w-dee/dotmatrix_64x48_hw_5.0/dotmatrix_64x48.pdf

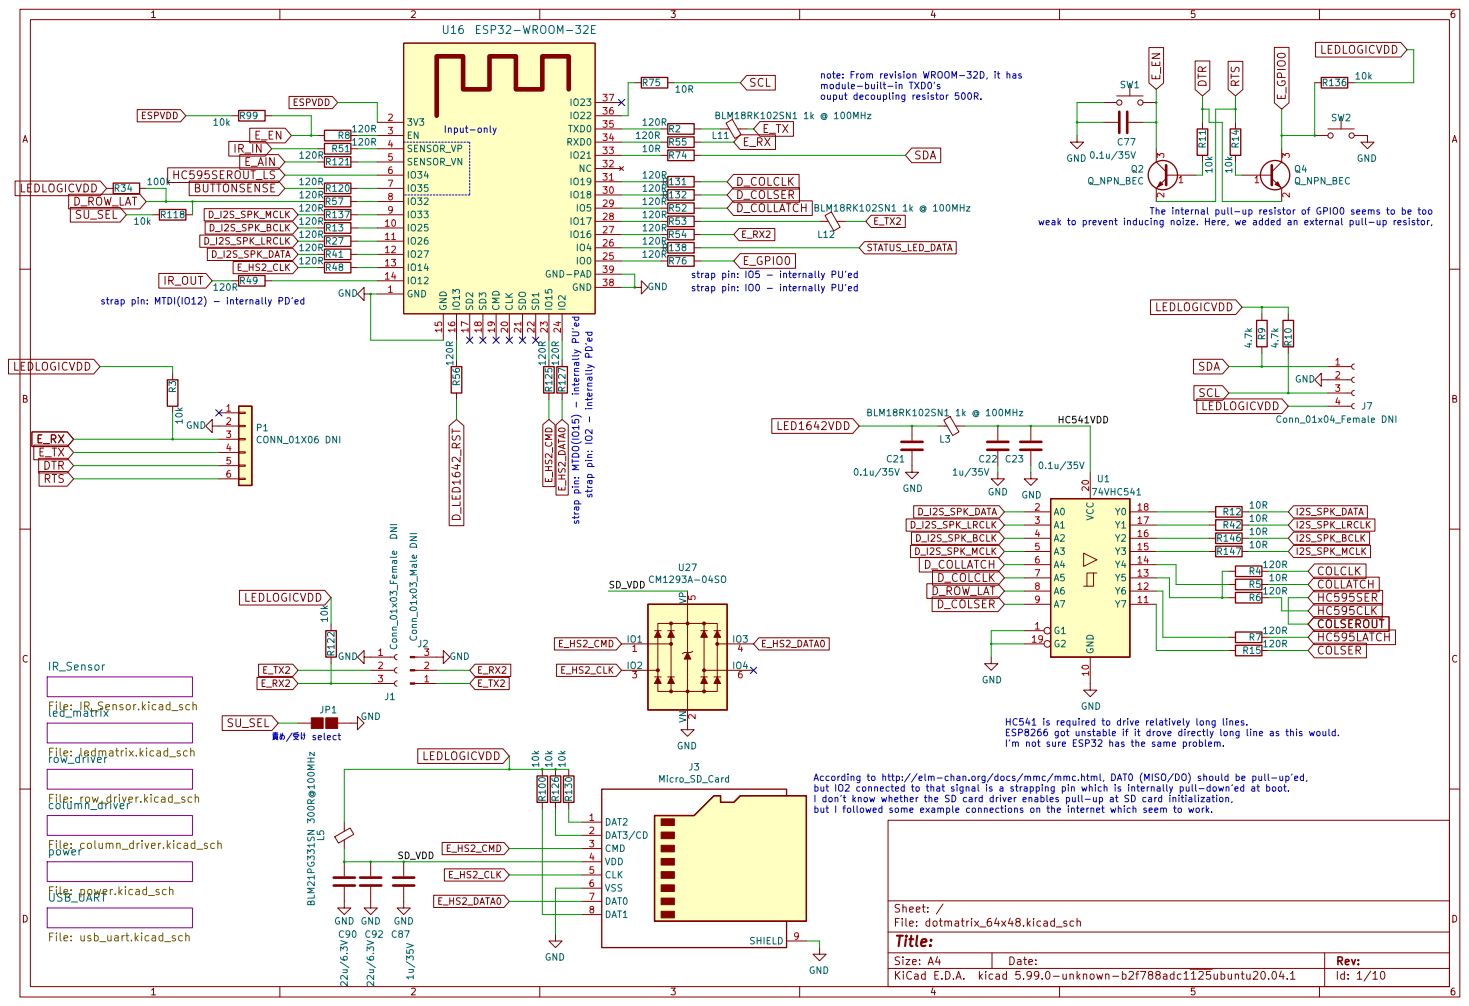
[picture p7: page 1]

note: From revision WROOM-32D, it has module-built-in TXD0's ouput decoupling resistor 500R.

The internal pull-up resistor of GPIO0 seems to be too

weak to prevent inducing noize. Here, we added an external pull-up resistor,

strap pin: IO5 - internally PU'ed
strap pin: IO0 - internally PU'ed

HC541 is required to drive relatively long lines.
ESP8266 got unstable if it drove directly long line as this would.
I'm not sure ESP32 has the same problem.

According to http://elm-chan.org/docs/mmc/mmc.html, DAT0 (MISO/DO) should be pull-up'ed,
but IO2 connected to that signal is a strapping pin which is internally pull-down'ed at boot.
I don't know whether the SD card driver enables pull-up at SD card initialization,
but I followed some example connections on the internet which seem to work.

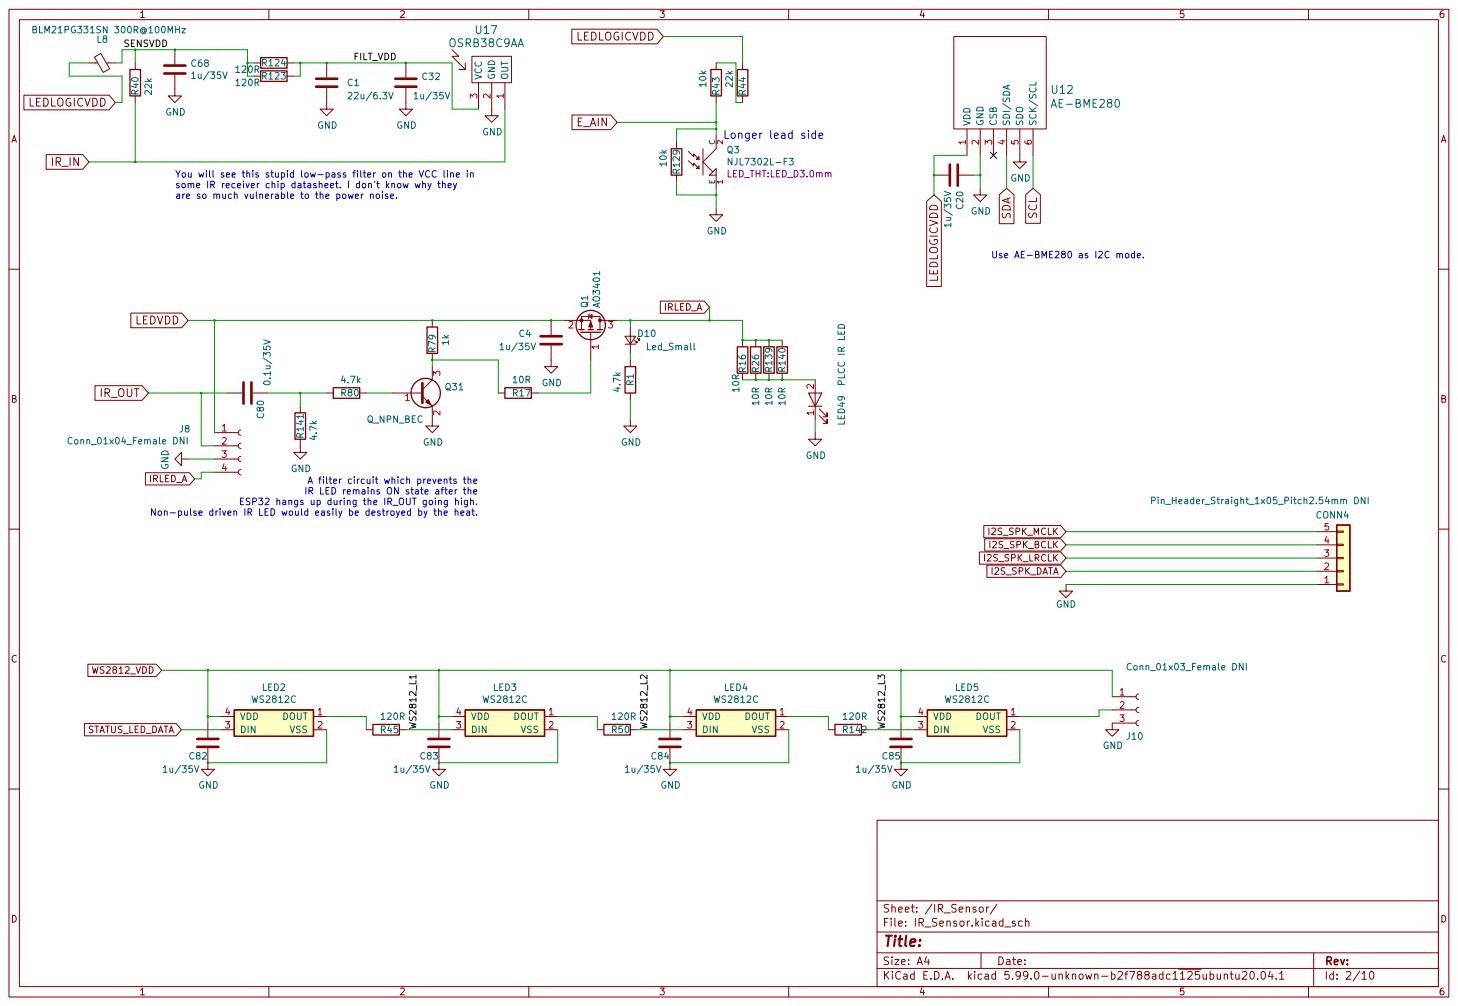
[picture p8: page 2]

You will see this stupid low-pass filter on the VCC line in
some IR receiver chip datasheet. I don't know why they
are so much vulnerable to the power noise.

1 2 LED49 PLCC IR LED GND GND

IR LED remains ON state after the ESP32 hangs up during the IR_OUT going high.

Non-pulse driven IR LED would easily be destroyed by the heat.

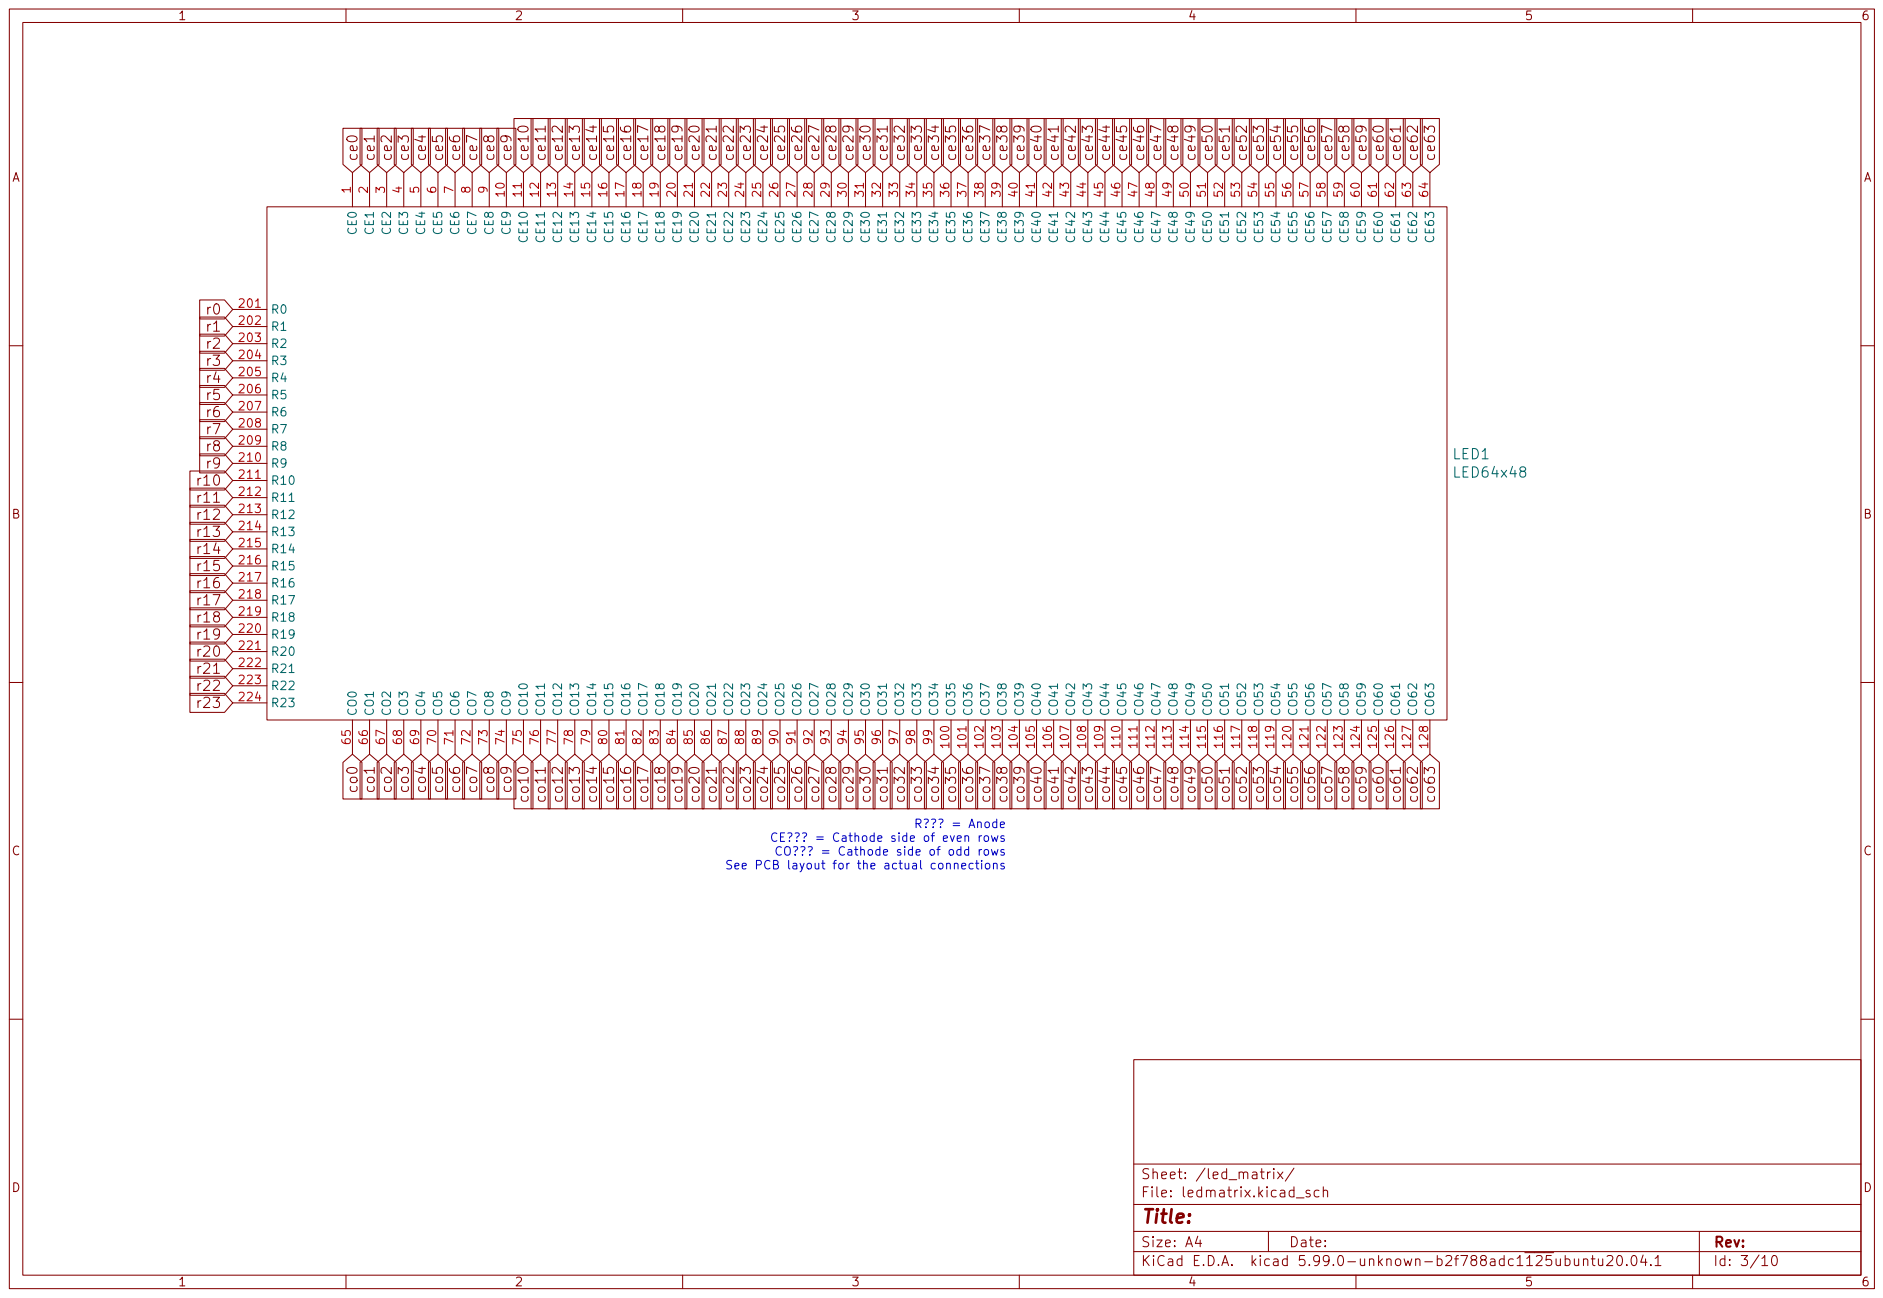
[picture p9: page 3]

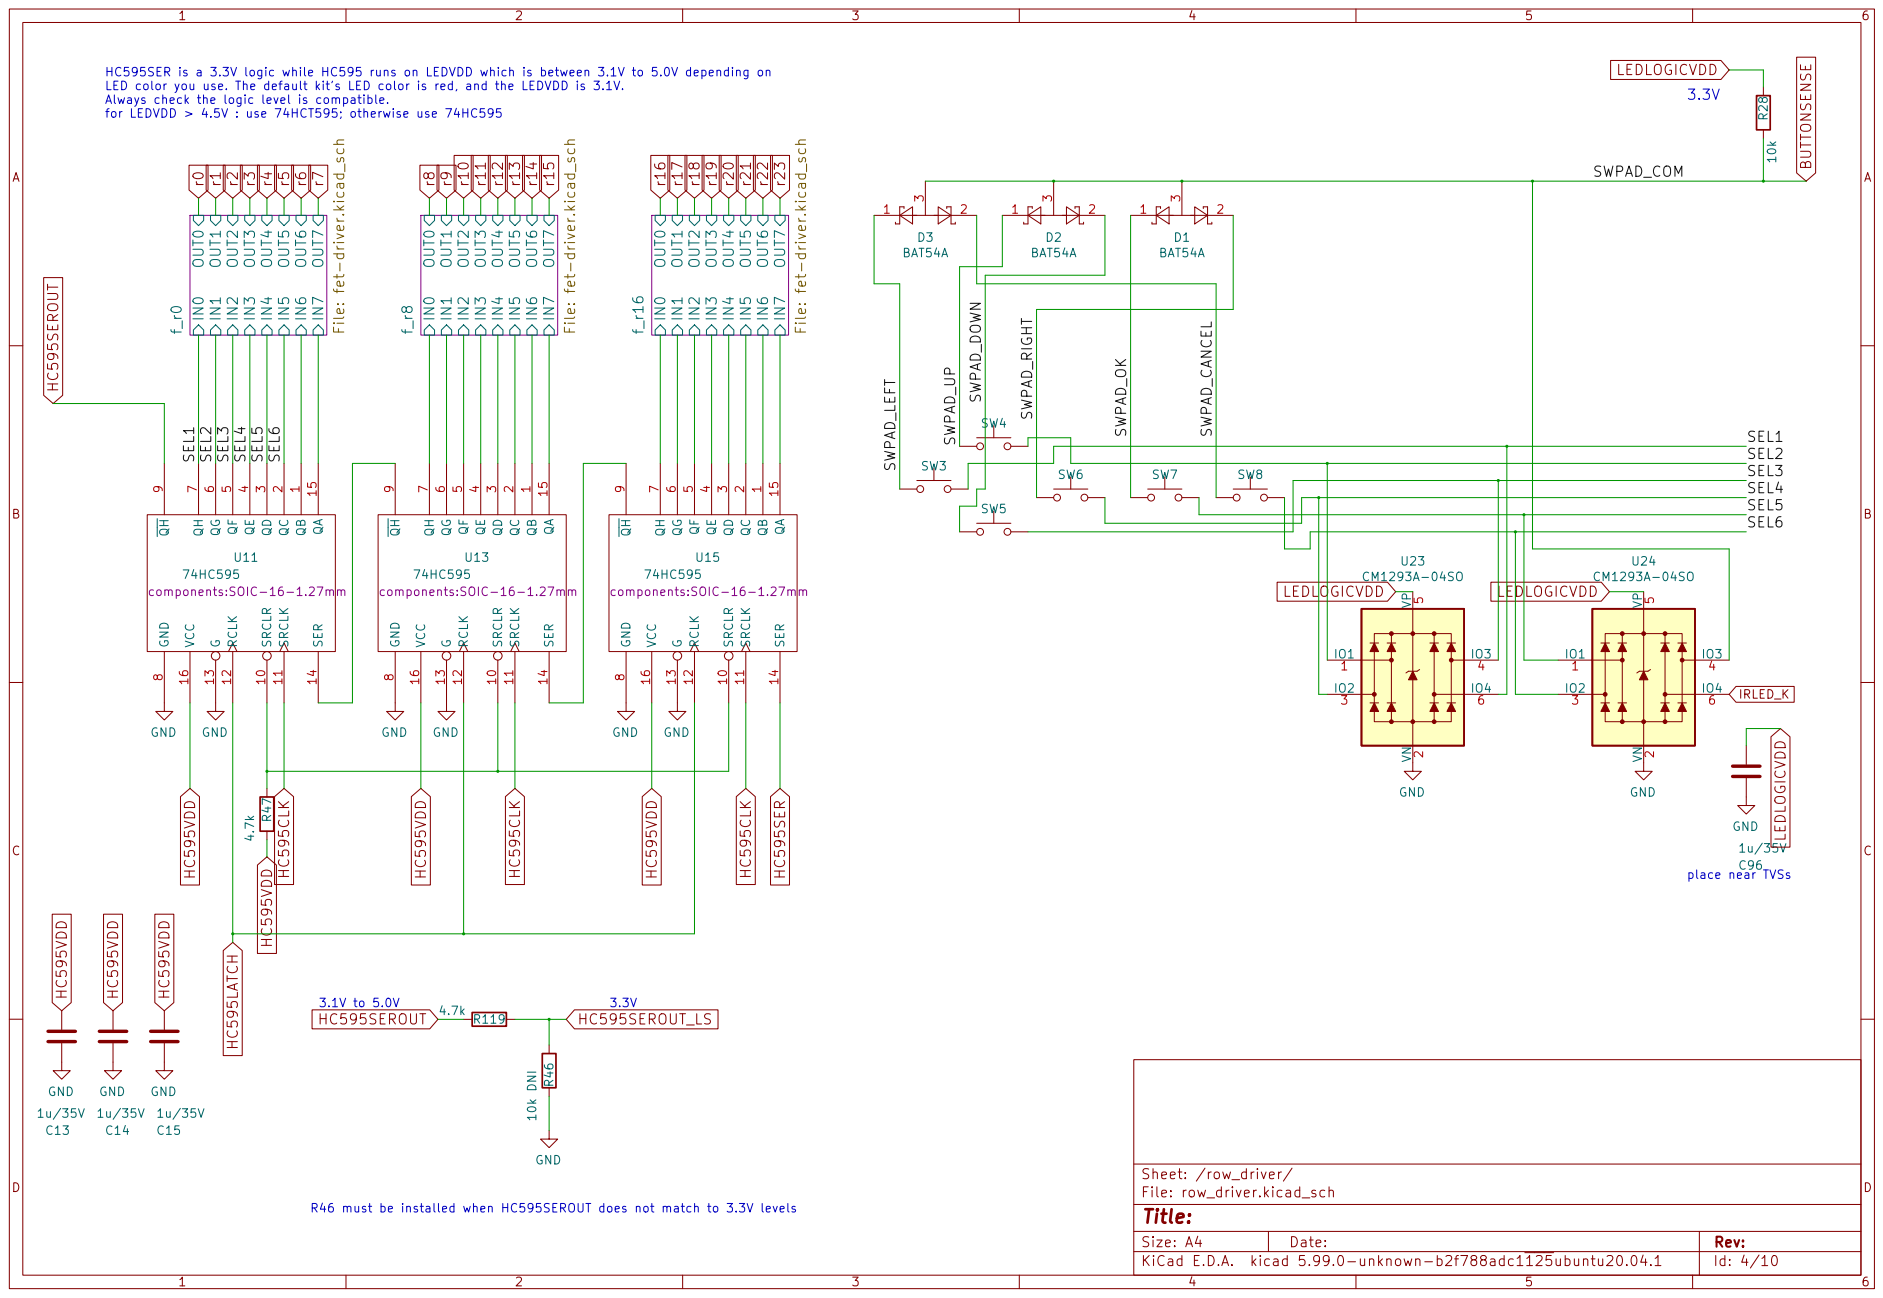
[picture p10: page 4]

HC595SER is a 3.3V logic while HC595 runs on LEDVDD which is between 3.1V to 5.0V depending on
LED color you use. The default kit's LED color is red, and the LEDVDD is 3.1V.
Always check the logic level is compatible.
for LEDVDD > 4.5V : use 74HCT595; otherwise use 74HC595

1 SRCLR 10 SRCLK 11 RCLK 12 G 13 SER 14 QA 15 VCC 16 QC

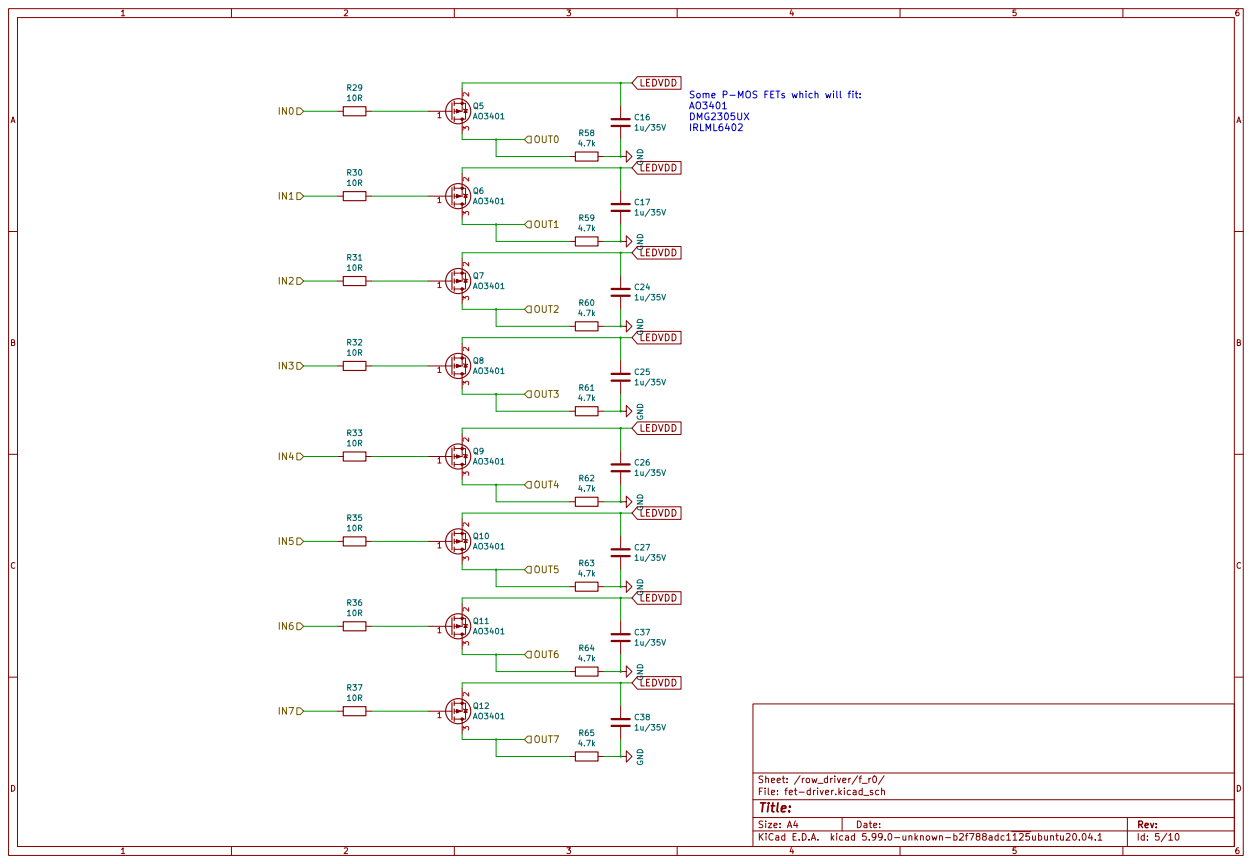
[picture p11: page 5]

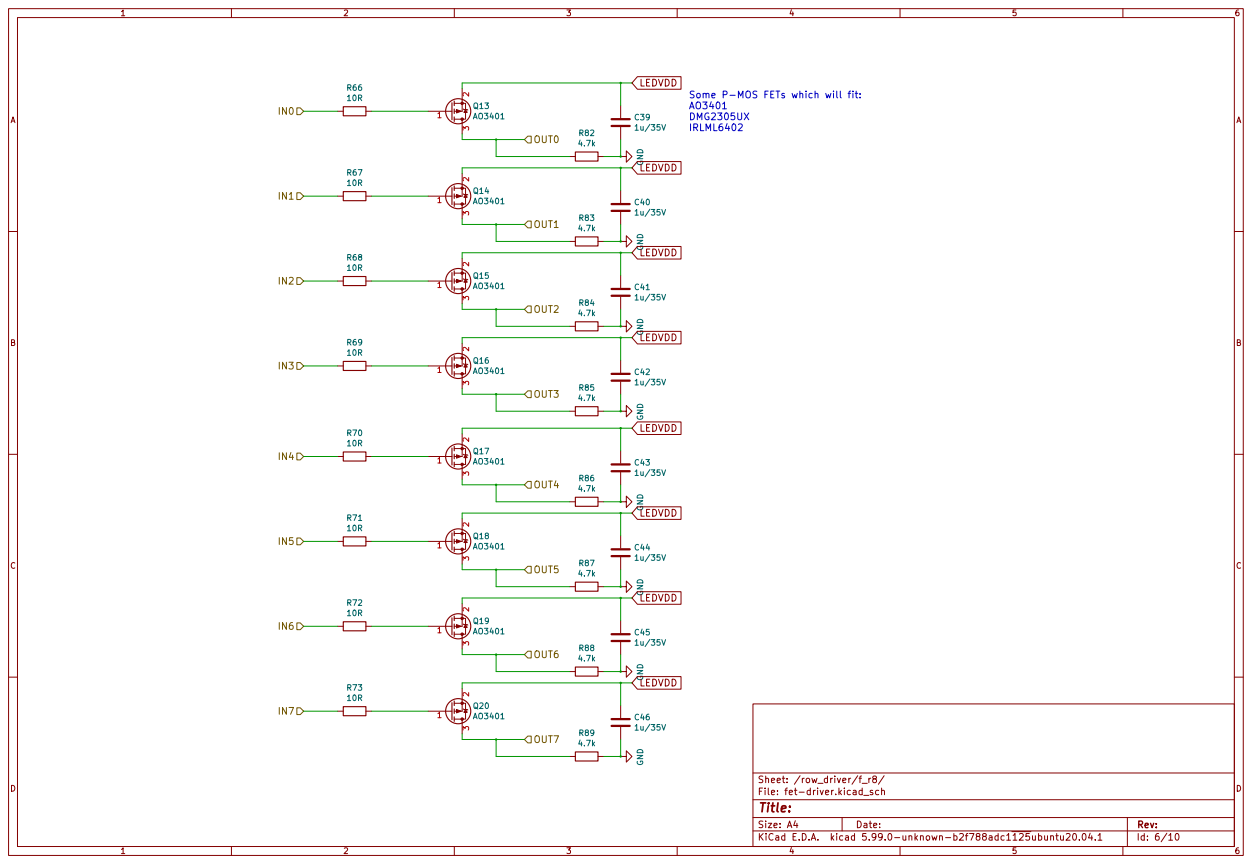
[picture p12: page 6]

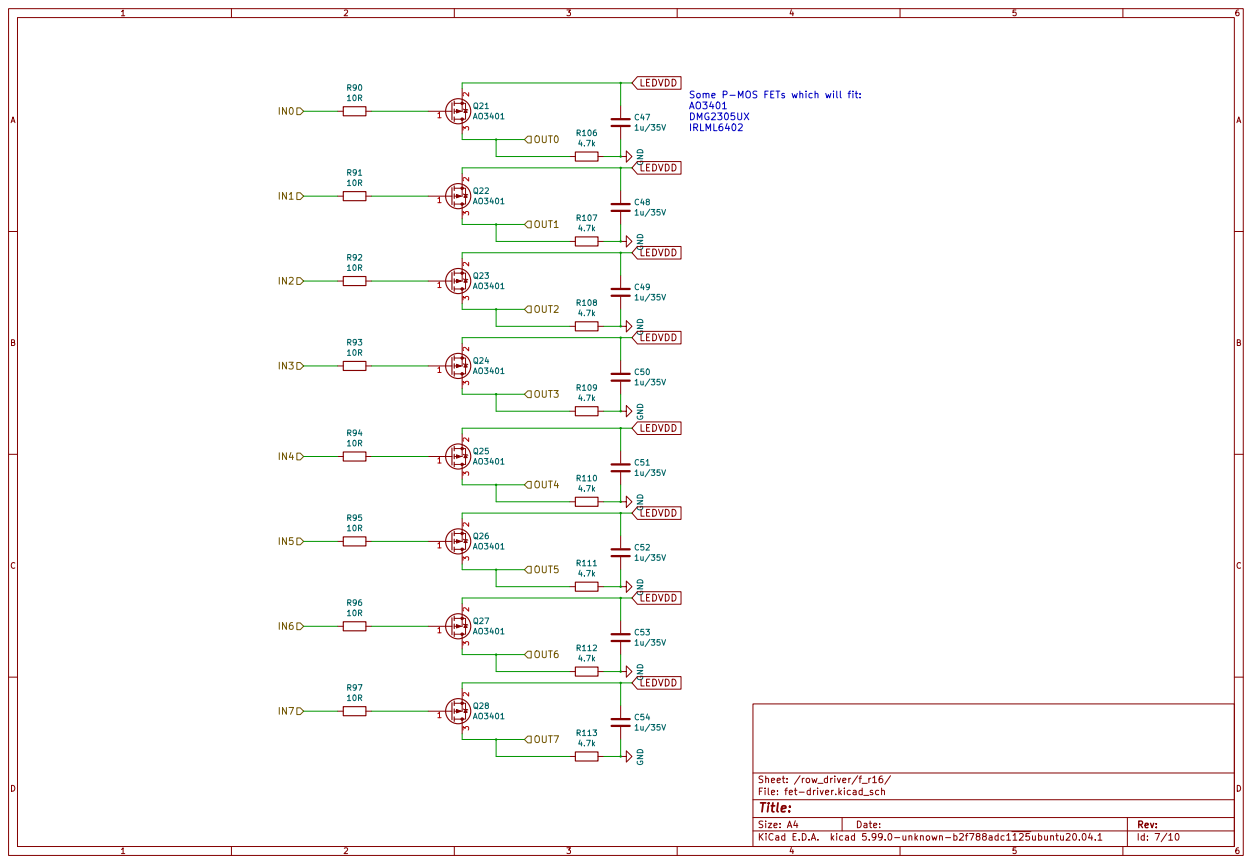
[picture p13: page 7]

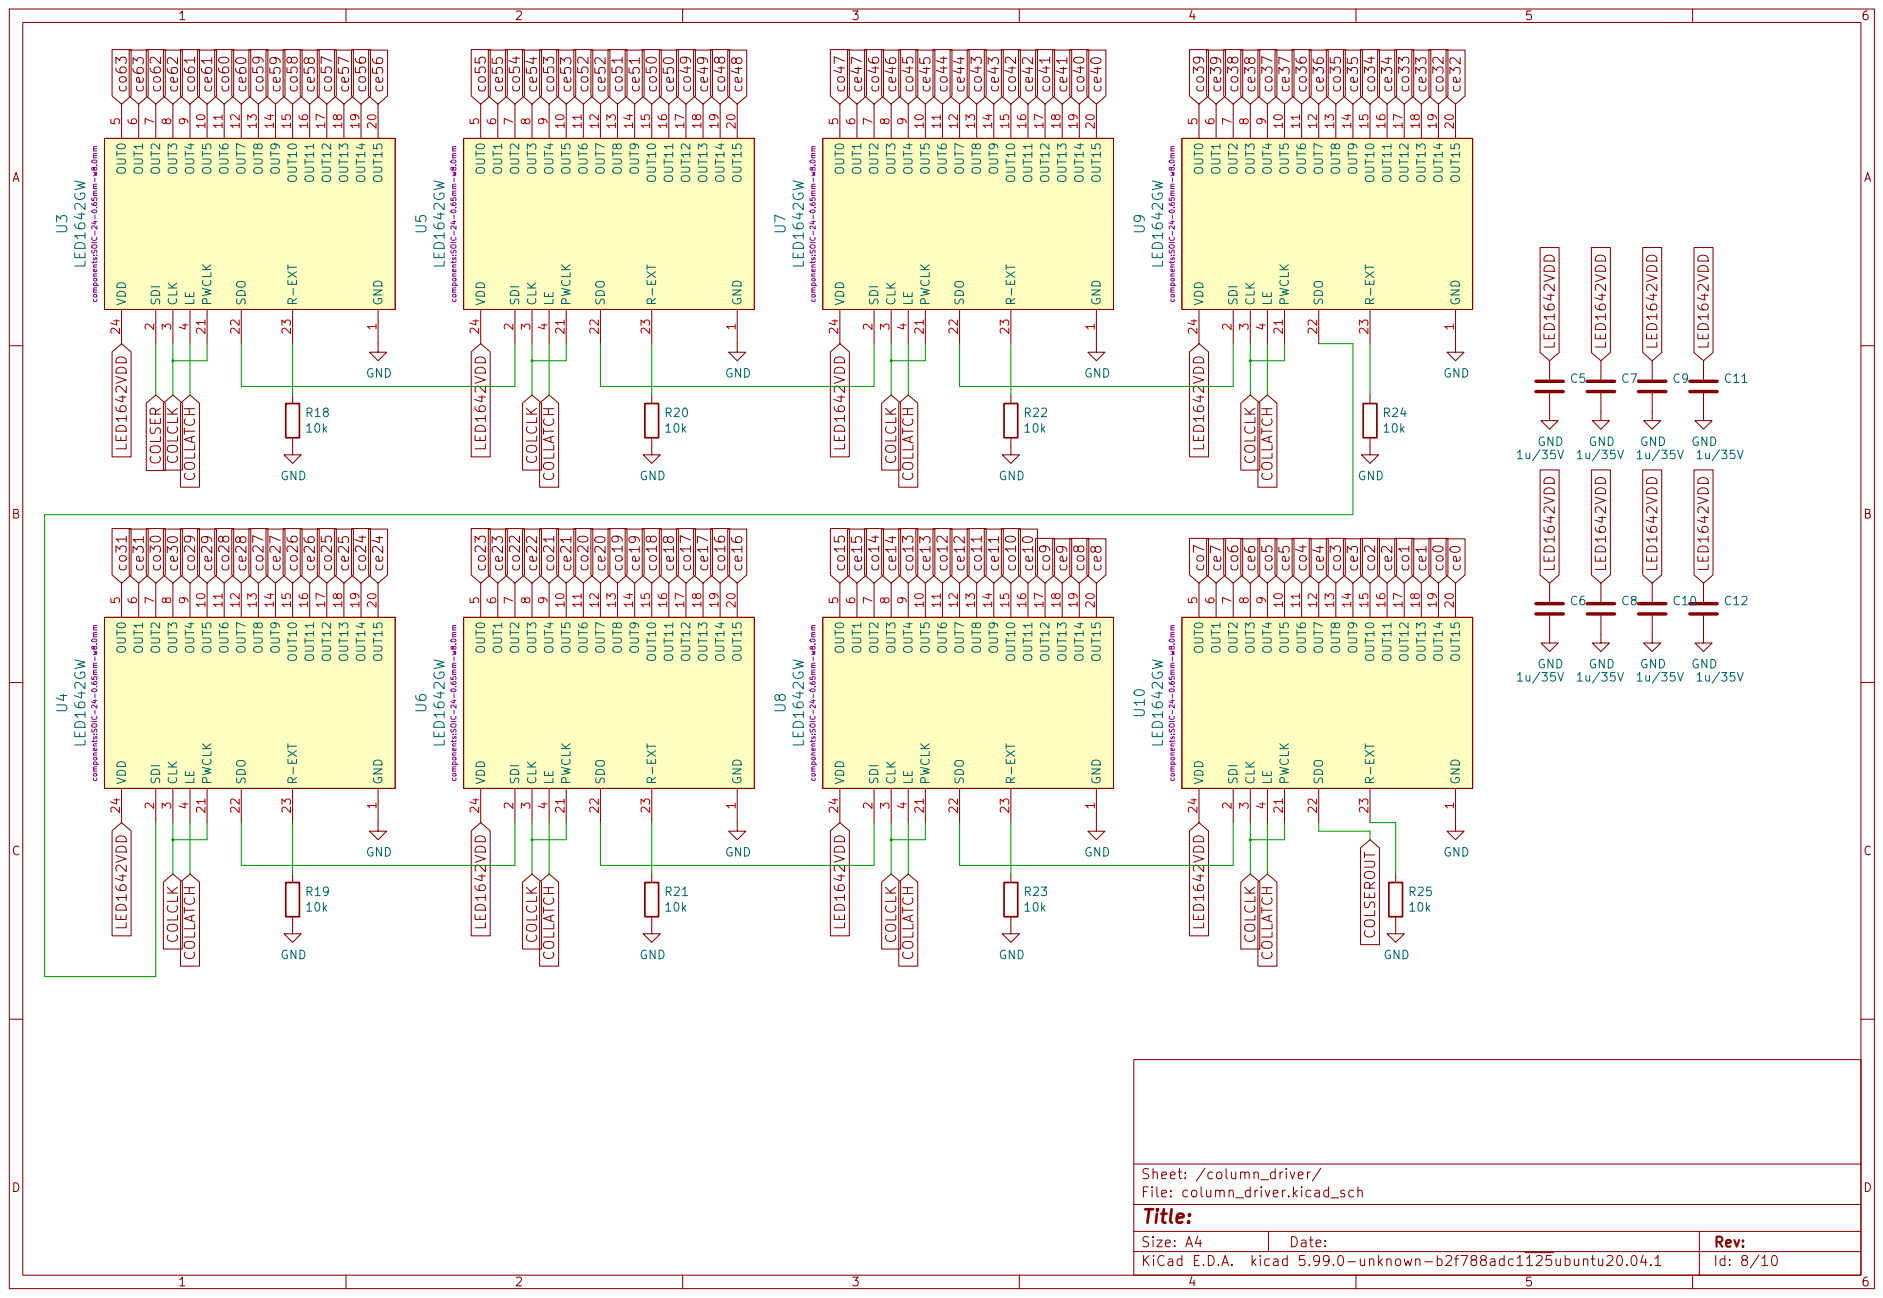
[picture p14: page 8]

9 U4 LED1642GW components:SOIC-24-0.65mm-w8.0mm GND GND GND ce15 ce14 co6 ce6 co5 ce5 co4 ce4 co3 ce3 ce49 COLLATCH COLCLK co14 co2 LED1642VDD COLCLK co48 ce48 co47 ce47 co46 ce46 co45 LED1642VDD COLCLK LED1642VDD ce7 COLLATCH COLSEROUT COLLATCH LED1642VDD ce9 co8 ce8 co7 COLCLK COLLATCH LED1642VDD ce37 co36 ce36 co35 ce35 co34 ce34 co33 ce33 co32 ce32 LED1642VDD co37 LED1642VDD LED1642VDD ce2 co1 ce1 co0 ce0 LED1642VDD LED1642VDD LED1642VDD LED1642VDD co43 ce13 co12 ce12 co11 ce11 co10 ce10 co9 ce45 co44 ce44 co13 co59 ce43 co42 ce42 co41 ce41 co40 ce40 co39 ce39 co38 ce38 co17 ce17 co16 ce16 co15 co63 ce63 co62 ce62 co61 ce61 co60 ce60 ce18 ce59 co58 ce58 co57 ce57 co56 ce56 co55 COLLATCH co29 ce29 co28 LED1642VDD ce25 LED1642VDD COLCLK COLLATCH co31 ce31 co30 ce30 ce28 co27 ce27 co26 ce26 co25 ce50 co24 ce24 co23 ce23 LED1642VDD COLCLK COLLATCH ce21 co20 ce20 co19 ce19 co18 COLCLK ce55 co54 ce54 co53 COLCLK COLLATCH co22 ce22 co21 ce53 LED1642VDD co52 COLSER ce52 co51 ce51 co50 co49

9 U3 LED1642GW components:SOIC-24-0.65mm-w8.0mm GND GND

1 OUT5 10 OUT6 11 OUT7 12 OUT8 13 OUT9 14 OUT10 15 OUT11 16 OUT12 17 OUT13 18 OUT14 19 SDI 2 OUT15 20 PWCLK 21 SDO 22 R-EXT 23 VDD 24 CLK

9 U7 LED1642GW components:SOIC-24-0.65mm-w8.0mm GND GND GND

9 U9 LED1642GW components:SOIC-24-0.65mm-w8.0mm GND GND GND

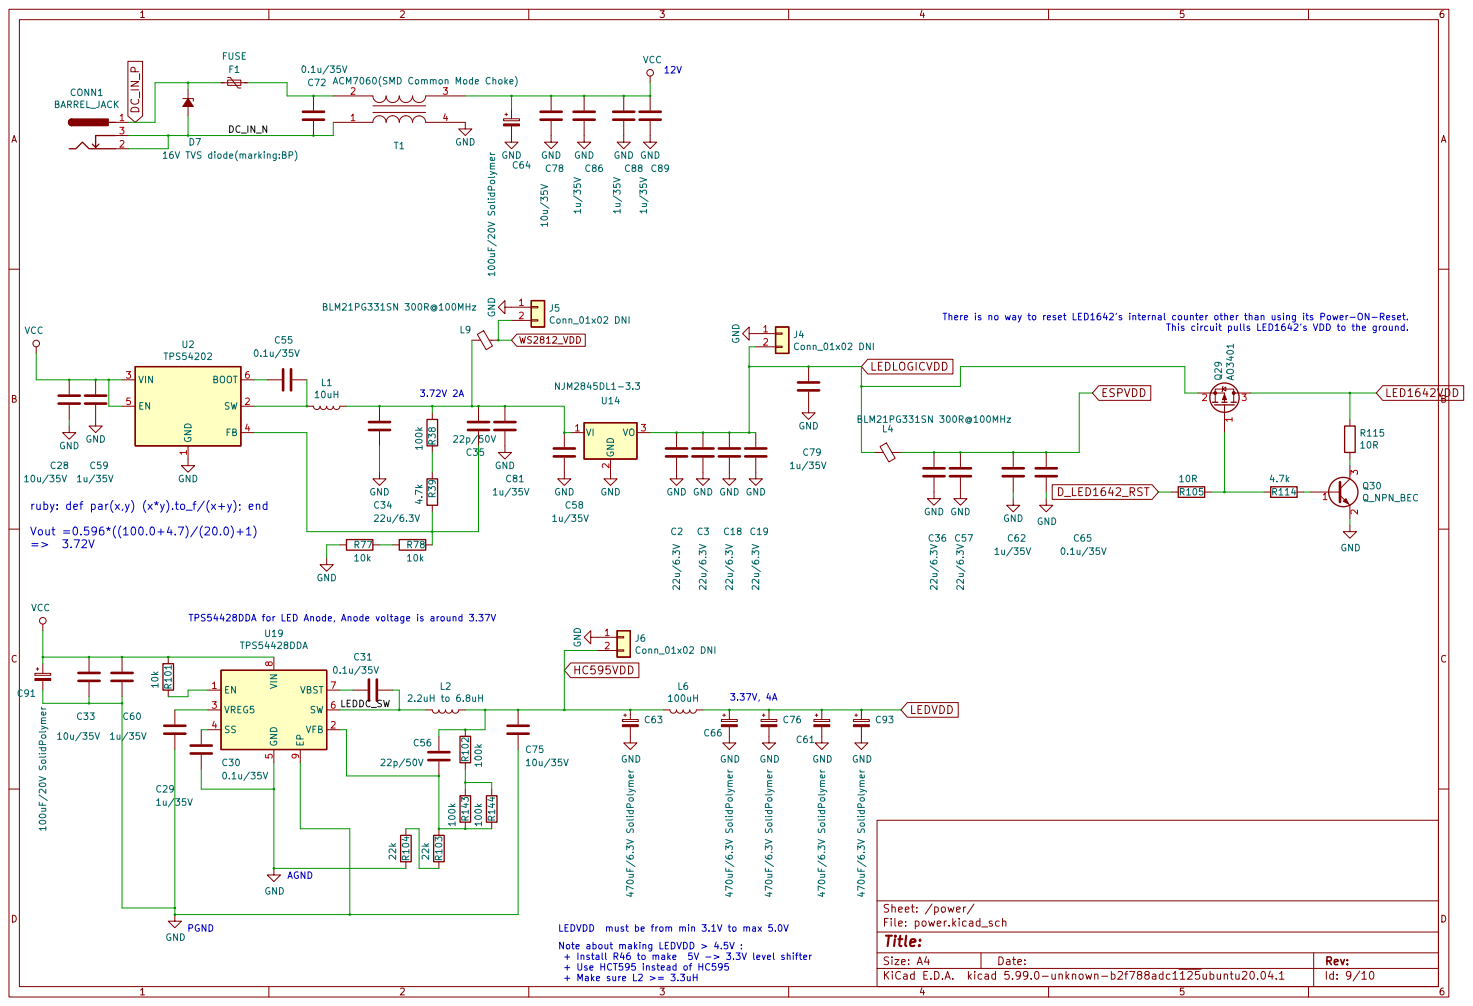
[picture p15: page 9]

This circuit pulls LED1642's VDD to the ground. 12V

There is no way to reset LED1642's internal counter other than using its Power-ON-Reset.

1 SW 2 VIN 3 FB 4 EN 5 BOOT 6 U2 TPS54202 GND GND GND GND

ruby: def par(x,y) (x*y).to_f/(x+y); end

TPS54428DDA for LED Anode, Anode voltage is around 3.37V

LEDVDD must be from min 3.1V to max 5.0V
Note about making LEDVDD > 4.5V :
+ Install R46 to make 5V -> 3.3V level shifter
+ Use HCT595 instead of HC595
+ Make sure L2 >= 3.3uH

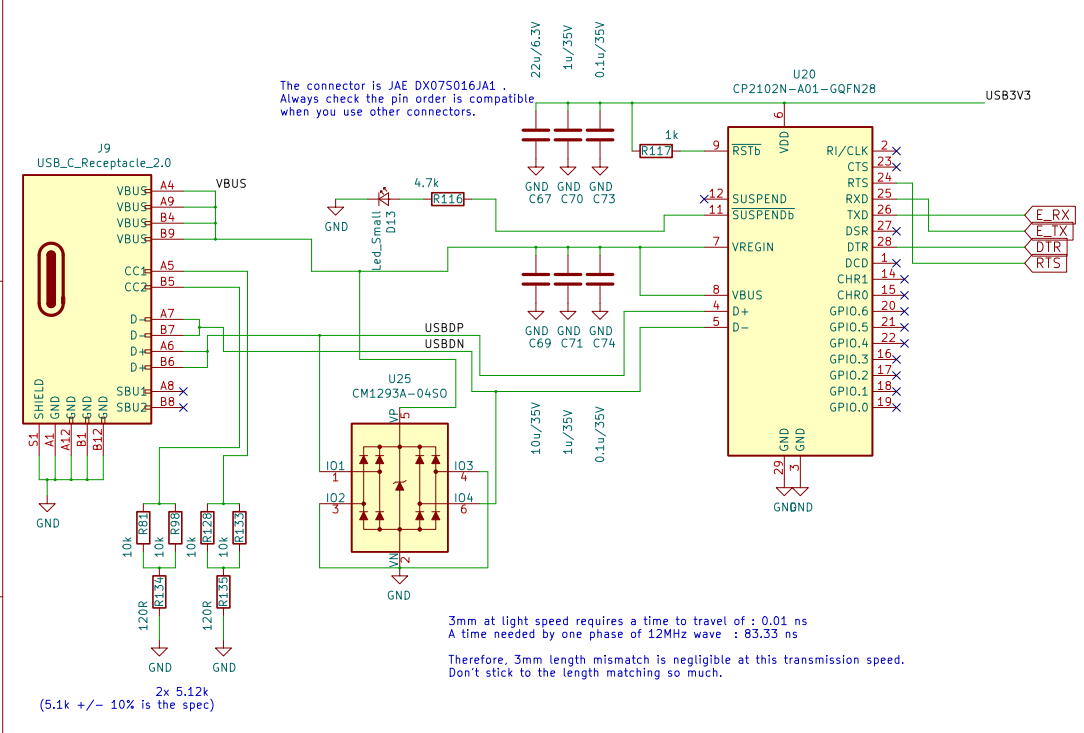
[picture p16: page 10]

USB3V3 The connector is JAE DX07S016JA1 . Always check the pin order is compatible

when you use other connectors. 2x 5.12k (5.1k +/- 10% is the spec)

3mm at light speed requires a time to travel of : 0.01 ns
A time needed by one phase of 12MHz wave : 83.33 ns

Therefore, 3mm length mismatch is negligible at this transmission speed.
Don't stick to the length matching so much.
