w-dee/dotmatrix_64x48_hw_5.0/dotmatrix_64x48.kicad_pcb

## KiCad design dotmatrix_64x48.kicad_pcb (2019-10-08)

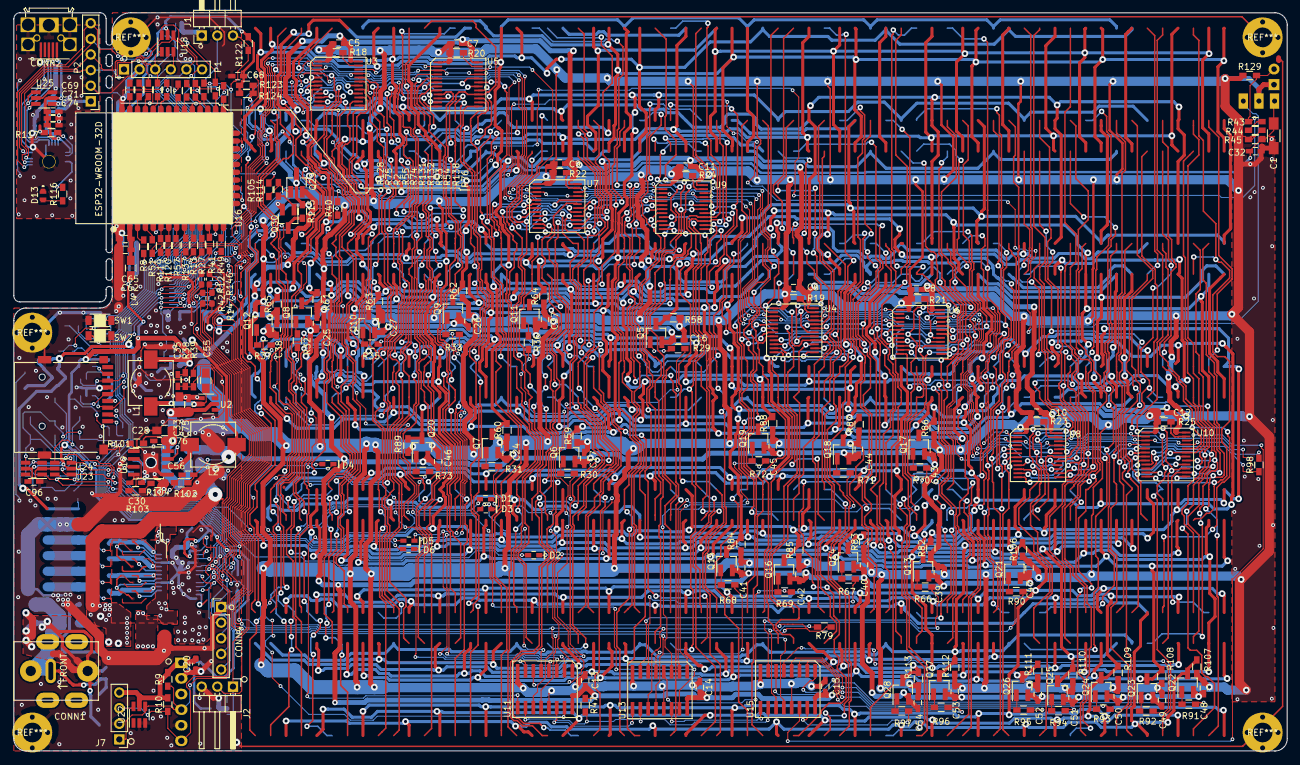
[picture p17: board dotmatrix_64x48.kicad_pcb from above]

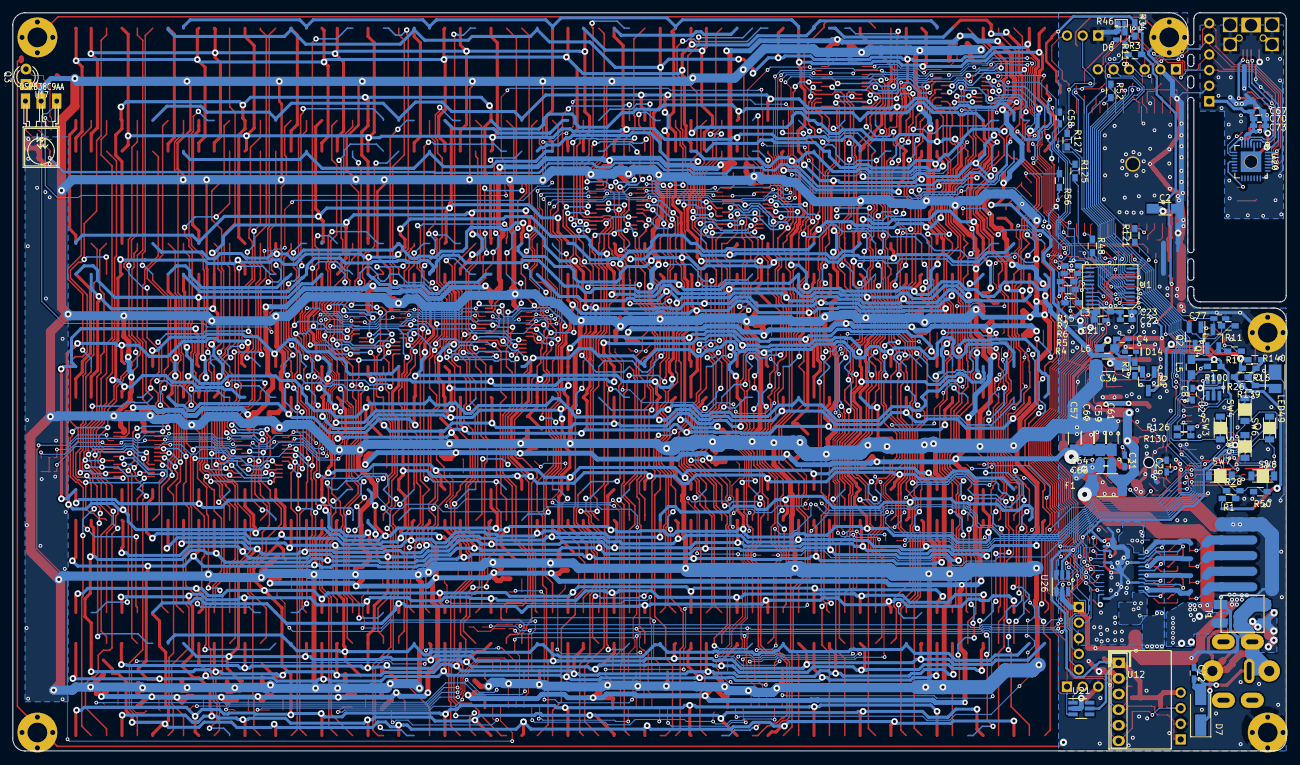
[picture p18: board dotmatrix_64x48.kicad_pcb from below]

Board: 2 copper layers, 207.0 x 120.0 mm, 307 parts (77 on the bottom side), 219 nets.

Parts:
C1, C2, C34, C57, C59, C60, C61: 10u; C_1206_HandSoldering
C4, C5, C6, C7, C8, C9, C10, C11, C12, C13, C14, C15, C16, C17, C22, C24, C25, C26, C27, C29, C32, C37, C38, C39, C40, C41, C42, C43, C44, C45, C46, C47, C48, C49, C50, C51, C52, C53, C54, C62, C64, C68, C70, C71, C87, C96: 1u; C_0603_HandSoldering
C20: 1u; C_0603_1608Metric_Pad1.05x0.95mm_HandSolder
C21, C23, C30, C31, C65, C66, C72, C73, C74, C77: 0.1u; C_0603_HandSoldering
C28, C33: 10u 16V; C_0805_HandSoldering
C35, C56: 22p; C_0603_HandSoldering
C55: 0.1u; C_0805_HandSoldering
C58: 0.1u DNI; C_0603_HandSoldering
C67, C69: 10u; C_0603_HandSoldering
C75, C76: 1u 16V; C_0603_HandSoldering
CONN1: BARREL_JACK; BARREL_JACK_HIGH_CURRENT_PJ018
CONN2: USB_OTG; USB-MICRO-B-RECEPT-UNIVERSAL
CONN4: Pin_Header_Straight_1x05_Pitch2.54mm
D1, D2, D3, D4, D5, D6, D14: D_Schottky_Small; SOD-523-mod
D7: 12V TVS diode; D_SMA_Handsoldering
D8, D13: Led_Small; LED1608_Handsoldering
F1: FUSE; R_1812
J1: Conn_01x03_Female; Pin_Header_Angled_1x03_Pitch2.54mm
J2: Conn_01x03_Male; Pin_Header_Angled_1x03_Pitch2.54mm
J3: Micro_SD_Card; microSD_Push_Push_SMD
J7: Conn_01x04_Female; Pin_Header_Straight_1x04_Pitch2.54mm
L1: 10uH; Choke_SMD_7.3x7.3_H3.5_handsoldering
L2: 2.2uH; Choke_SMD_7.3x7.3_H3.5_handsoldering
L3: BLM18RK102SN1 1k @ 100MHz; R_0603_HandSoldering
L4, L5, L6: BLM21PG331SN 300R@100MHz; C_0805_HandSoldering
LED49: IR; LED_PLCC_2835_Handsoldering
P1, P2: CONN_01X06; Pin_Header_Straight_1x06_Pitch2.54mm
Q1, Q5, Q6, Q7, Q8, Q9, Q10, Q11, Q12, Q13, Q14, Q15, Q16, Q17, Q18, Q19, Q20, Q21, Q22, Q23, Q24, Q25, Q26, Q27, Q28, Q29: AO3401; SOT-23_Handsoldering
Q2, Q4, Q30: Q_NPN_BEC; SOT-23_Handsoldering
Q3: NJL7302L-F3; LED_D3.0mm
R1, R9, R10, R47, R58, R59, R60, R61, R62, R63, R64, R65, R82, R83, R84, R85, R86, R87, R88, R89, R106, R107, R108, R109, R110, R111, R112, R113, R114, R138: 4.7k; R_0603_HandSoldering
R2, R5, R16, R17, R26, R29, R30, R31, R32, R33, R35, R36, R37, R66, R67, R68, R69, R70, R71, R72, R73, R74, R75, R90, R91, R92, R93, R94, R95, R96, R97, R105, R115, R139, R140: 10R; R_0603_HandSoldering
R3, R11, R14, R28, R43, R44, R45, R100, R101, R104, R118, R122, R126, R129, R130: 10k; R_0603_HandSoldering
R4, R6, R7, R8, R13, R15, R27, R41, R48, R49, R51, R52, R53, R54, R55, R56, R57, R76, R119, R120, R121, R123, R124, R125, R127, R128, R131, R132, R137: 120R; R_0603_HandSoldering
R12, R42, R146, R147: 10R; R_0603_1608Metric_Pad1.05x0.95mm_HandSolder
R18, R19, R20, R21, R22, R23, R24, R25, R39, R40, R103: 22k; R_0603_HandSoldering
R34, R38, R102: 100k; R_0603_HandSoldering
R46: 0; SolderJumper_S
R50: 10k DNI; R_0603_HandSoldering
R77, R78, R80, R81, R133, R134, R135, R136: 0; J_0.16mm
R79, R98, R116, R117: 1k; R_0603_HandSoldering
SW1, SW2, SW3, SW4, SW5, SW6, SW7, SW8: SW_PUSH_SMALL_H; TACT_SW_SMD_Panasonic-EVPAWBD2A
T1: COMMON_MODE_CHOKE; Choke_COMMON_SMD_ACM7060
U1: 74VHC541; SOIC-20-0.65mm-w8.0mm
U2: TPS54202; SOT-23-6
U3, U4, U5, U6, U7, U8, U9, U10: LED1642GW; SOIC-24-0.65mm-w8.0mm
U11, U13, U15: 74HC595; SOIC-16-1.27mm
U12: AE-BME280
U16: ESP32-WROOM
U17: OSRB38C9AA; IRM2161_LAY
U18, U21, U22, U23, U24, U25, U26, U27: CM1293A-04SO; SOT-23-6_Handsoldering
U19: TPS54428DDA; TI_SO-PowerPAD-8
U20: CP2102N-A01-GQFN28; QFN-28-1EP_5x5mm_Pitch0.5mm-handsoldering

Connections:
/CC_GUARD0: R80.2, R135.1
/CC_GUARD1: R81.2, R136.1
/HC541VDD: C22.1, C23.1, L3.2, U1.20
/IR_Sensor/FILT_VDD: C1.1, C32.1, R45.2, R123.1, R124.1, U17.3
/RC_GUARD0: R77.2, R133.1
/RC_GUARD1: R78.2, R134.1
/SD_VDD: C87.1, J3.4, L5.2, U27.5
/USB_UART/USB3V3: C67.1, C70.1, C73.1, P2.1, R117.2, U20.6
/USB_UART/USBDN: CONN2.2, U20.5, U25.3
/USB_UART/USBDP: CONN2.3, U20.4, U25.1
/USB_UART/VBUS: C69.1, C71.1, C74.1, CONN2.1, U20.7, U20.8, U25.5
/power/DC_IN_N: C72.2, CONN1.2, CONN1.3, D7.2, T1.2
/power/LEDDC_SW: C31.2, L2.2, U19.6
/row_driver/IN0: R66.2, U13.7
/row_driver/IN0_1: R90.2, U15.7
/row_driver/IN1: R91.2, U15.6
/row_driver/IN1_1: R67.2, U13.6
/row_driver/IN2: R92.2, U15.5
/row_driver/IN2_1: R68.2, U13.5
/row_driver/IN3: R93.2, U15.4
/row_driver/IN3_1: R69.2, U13.4
/row_driver/IN4: R94.2, U15.3
/row_driver/IN4_1: R70.2, U13.3
/row_driver/IN5: R95.2, U15.2
/row_driver/IN5_1: R71.2, U13.2
/row_driver/IN6: R96.2, U15.1
/row_driver/IN6_1: R36.2, U11.1
/row_driver/IN6_2: R72.2, U13.1
/row_driver/IN7: R37.2, U11.15
/row_driver/IN7_1: R97.2, U15.15
/row_driver/IN7_2: R73.2, U13.15
/row_driver/SEL1: D1.1, R29.2, U11.7
/row_driver/SEL2: D2.1, R30.2, U11.6
/row_driver/SEL3: D3.1, R31.2, U11.5
/row_driver/SEL4: D4.1, R32.2, U11.4
/row_driver/SEL5: D5.1, R33.2, U11.3
/row_driver/SEL6: D6.1, R35.2, U11.2
/row_driver/SWPAD_CANCEL: D6.2, SW8.1, U24.3
/row_driver/SWPAD_DOWN: D3.2, SW5.1, U23.4
/row_driver/SWPAD_LEFT: D1.2, SW3.1, U23.1
/row_driver/SWPAD_OK: D5.2, SW7.1, U24.1
/row_driver/SWPAD_RIGHT: D4.2, SW6.1, U23.6
/row_driver/SWPAD_UP: D2.2, SW4.1, U23.3
BUTTONSENSE: R28.2, R50.1, R120.2, SW3.2, SW4.2, SW5.2, SW6.2, SW7.2, SW8.2, U24.4
COLCLK: R4.2, R98.2, U3.3, U3.21, U4.3, U4.21, U5.3, U5.21, U6.3, U6.21, U7.3, U7.21, U8.3, U8.21, U9.3, U9.21, U10.3, U10.21
COLLATCH: R5.2, U3.4, U4.4, U5.4, U6.4, U7.4, U8.4, U9.4, U10.4
COLSER: R15.2, U3.2
COLSEROUT: U10.22, U15.14
DC_IN_P: C72.1, CONN1.1, D7.1, T1.1
DTR: P1.5, P2.5, Q4.2, R11.2, U18.4, U20.28
D_COLCLK: R131.2, U1.9
D_COLLATCH: R52.1, U1.8
D_COLSER: R132.2, U1.6
D_I2S_SPK_BCLK: R13.2, U1.4
D_I2S_SPK_DATA: R41.2, U1.2
D_I2S_SPK_LRCLK: R27.2, U1.3
D_I2S_SPK_MCLK: R137.2, U1.5
D_LED1642_RST: R56.1, R105.1
D_ROW_LAT: R34.1, R57.1, R118.1, U1.7
ESPVDD: C2.1, C62.1, C65.1, L4.2, U16.2
E_AIN: C58.1, Q3.2, R43.1, R121.1, R129.2
E_EN: C77.2, Q2.3, R8.1, SW1.1
E_GPIO0: Q4.3, R76.1, SW2.2
E_HS2_CLK: J3.5, R48.2, U27.3
E_HS2_CMD: J3.3, R125.1, U27.1
E_HS2_DATA0: J3.7, R127.1, U27.4
E_RX: P1.3, P2.3, R3.1, R55.1, U18.1, U20.26
E_RX2: J1.3, J2.2, R54.2, R122.1, U21.1
E_TX: P1.4, P2.4, R2.1, U18.3, U20.25
E_TX2: J1.2, J2.1, R53.2, U21.3
GND: C1.2, C2.2, C4.2, C5.2, C6.2, C7.2, C8.2, C9.2, C10.2, C11.2, C12.2, C13.2, C14.2, C15.2, C16.2, C17.2, C20.1, C21.2, C22.2, C23.2, C24.2, C25.2, C26.2, C27.2, C28.2, C29.2, C30.2, C32.2, C33.2, C34.2, C37.2, C38.2, C39.2, C40.2, C41.2, C42.2, C43.2, C44.2, C45.2, C46.2, C47.2, C48.2, C49.2, C50.2, C51.2, C52.2, C53.2, C54.2, C57.2, C58.2, C59.2, C60.2, C61.2, C62.2, C64.2, C65.2, C66.2, C67.2, C68.2, C69.2, C70.2, C71.2, C73.2, C74.2, C75.2, C76.2, C77.1, C87.2, C96.2, CONN2.5, CONN2.6, CONN4.1, D8.1, D13.1, D14.2, J1.1, J2.3, J3.6, J3.9, J7.2, LED49.1, P1.2, P2.2, Q3.1, Q30.2, R1.1, R18.2, R19.2, R20.2, R21.2, R22.2, R23.2, R24.2, R25.2, R39.1, R46.2, R50.2, R58.1, R59.1, R60.1, R61.1, R62.1, R63.1, R64.1, R65.1, R77.1, R78.1, R80.1, R81.1, R82.1, R83.1, R84.1, R85.1, R86.1, R87.1, R88.1, R89.1, R104.1, R106.1, R107.1, R108.1, R109.1, R110.1, R111.1, R112.1, R113.1, R129.1, SW1.2, SW2.1, T1.3, U1.1, U1.10, U1.19, U2.1, U3.1, U4.1, U5.1, U6.1, U7.1, U8.1, U9.1, U10.1, U11.8, U11.13, U12.2, U12.5, U13.8, U13.13, U15.8, U15.13, U16.1, U16.15, U16.38, U16.39, U17.2, U18.2, U19.5, U19.9, U20.3, U20.29, U21.2, U22.2, U22.3, U23.2, U24.2, U25.2, U25.4, U25.6, U26.2, U27.2
HC595CLK: R6.2, R79.2, U11.11, U13.11, U15.11
HC595LATCH: R7.2, U11.12, U13.12, U15.12
HC595SEROUT: R119.2, U11.9
I2S_SPK_BCLK: CONN4.4, R42.2, U26.3
I2S_SPK_DATA: CONN4.2, R147.2, U26.6
I2S_SPK_LRCLK: CONN4.3, R146.2, U26.4
I2S_SPK_MCLK: CONN4.5, R12.2, U26.1
IRLED_A: Q1.3, R1.2, R16.2, R26.2, R139.2, R140.2
IR_IN: R40.2, R51.1, U17.1
IR_OUT: D14.1, R17.2, R49.2
LED1642VDD: C5.1, C6.1, C7.1, C8.1, C9.1, C10.1, C11.1, C12.1, C21.1, L3.1, Q29.3, R115.1, U3.24, U4.24, U5.24, U6.24, U7.24, U8.24, U9.24, U10.24
LEDLOGICVDD: C20.2, C34.1, C35.1, C68.1, C96.1, J7.4, L1.1, L4.1, L5.1, Q29.2, R3.2, R9.2, R10.2, R28.1, R34.2, R38.2, R40.1, R100.2, R122.2, R123.2, R124.2, R126.2, R130.2, U12.1, U18.5, U21.5, U22.5, U23.5, U24.5, U26.5
LEDVDD: C13.1, C14.1, C15.1, C16.1, C17.1, C24.1, C25.1, C26.1, C27.1, C37.1, C38.1, C39.1, C40.1, C41.1, C42.1, C43.1, C44.1, C45.1, C46.1, C47.1, C48.1, C49.1, C50.1, C51.1, C52.1, C53.1, C54.1, C56.1, C57.1, C59.1, C60.1, C61.1, L2.1, L6.1, Q5.2, Q6.2, Q7.2, Q8.2, Q9.2, Q10.2, Q11.2, Q12.2, Q13.2, Q14.2, Q15.2, Q16.2, Q17.2, Q18.2, Q19.2, Q20.2, Q21.2, Q22.2, Q23.2, Q24.2, Q25.2, Q26.2, Q27.2, Q28.2, R47.1, R102.2, U11.16, U13.16, U15.16
MS_SEL: R46.1, R118.2
unnamed: C4.1, L6.2, Q1.2
unnamed: C29.1, U19.3
unnamed: C30.1, U19.4
unnamed: C31.1, U19.7
unnamed: C35.2, R38.1, R39.2, U2.4
unnamed: C55.1, U2.6
unnamed: C55.2, L1.2, U2.2
unnamed: C56.2, R102.1, R103.2, U19.2
unnamed: D8.2, R138.2
unnamed: D13.2, R116.1
unnamed: J3.1, R130.1
unnamed: J3.2, R126.1
unnamed: J3.8, R100.1
unnamed: LED49.2, R16.1, R26.1, R139.1, R140.1
unnamed: Q1.1, R17.1
unnamed: Q2.1, R11.1
unnamed: Q4.1, R14.1
unnamed: Q5.1, R29.1
unnamed: Q6.1, R30.1
unnamed: Q7.1, R31.1
unnamed: Q8.1, R32.1
unnamed: Q9.1, R33.1
unnamed: Q10.1, R35.1
unnamed: Q11.1, R36.1
unnamed: Q12.1, R37.1
unnamed: Q13.1, R66.1
unnamed: Q14.1, R67.1
unnamed: Q15.1, R68.1
unnamed: Q16.1, R69.1
unnamed: Q17.1, R70.1
unnamed: Q18.1, R71.1
unnamed: Q19.1, R72.1
unnamed: Q20.1, R73.1
unnamed: Q21.1, R90.1
unnamed: Q22.1, R91.1
unnamed: Q23.1, R92.1
unnamed: Q24.1, R93.1
unnamed: Q25.1, R94.1
unnamed: Q26.1, R95.1
unnamed: Q27.1, R96.1
unnamed: Q28.1, R97.1
unnamed: Q29.1, R105.2, R114.1
unnamed: Q30.1, R114.2
unnamed: Q30.3, R115.2
unnamed: R2.2, U16.35
unnamed: R4.1, R6.1, U1.13
unnamed: R5.1, U1.14
unnamed: R7.1, U1.12
unnamed: R8.2, U16.3
unnamed: R12.1, U1.18
unnamed: R13.1, U16.10
unnamed: R15.1, U1.11
unnamed: R18.1, U3.23
unnamed: R19.1, U4.23
unnamed: R20.1, U5.23
unnamed: R21.1, U6.23
unnamed: R22.1, U7.23
unnamed: R23.1, U8.23
unnamed: R24.1, U9.23
unnamed: R25.1, U10.23
unnamed: R27.1, U16.11
unnamed: R41.1, U16.12
unnamed: R42.1, U1.17
unnamed: R43.2, R44.1
unnamed: R44.2, R45.1
unnamed: R47.2, U11.10, U13.10, U15.10
unnamed: R48.1, U16.13
unnamed: R49.1, U16.14
unnamed: R51.2, U16.4
unnamed: R52.2, U16.29
unnamed: R53.1, U16.28
unnamed: R54.1, U16.27
unnamed: R55.2, U16.34
unnamed: R56.2, U16.16
unnamed: R57.2, U16.8
unnamed: R74.2, U16.33
unnamed: R75.2, U16.36
unnamed: R76.2, U16.25
unnamed: R101.1, U19.1
unnamed: R103.1, R104.2
unnamed: R116.2, U20.11
unnamed: R117.1, U20.9
unnamed: R119.1, U16.6
unnamed: R120.1, U16.7
unnamed: R121.2, U16.5
unnamed: R125.2, U16.23
unnamed: R127.2, U16.24
unnamed: R128.2, U16.37
unnamed: R131.1, U16.31
unnamed: R132.1, U16.30
unnamed: R79.1, R133.2, R134.2
unnamed: R98.1, R135.2, R136.2
unnamed: R137.1, U16.9
unnamed: R138.1, U16.26
unnamed: R146.1, U1.16
unnamed: R147.1, U1.15
unnamed: U3.22, U5.2
unnamed: U4.2, U9.22
unnamed: U4.22, U6.2
unnamed: U5.22, U7.2
unnamed: U6.22, U8.2
unnamed: U7.22, U9.2
unnamed: U8.22, U10.2
unnamed: U11.14, U13.9
unnamed: U13.14, U15.9
RTS: P1.6, P2.6, Q2.2, R14.2, U18.6, U20.24
SCL: J7.3, R10.1, R75.1, U12.6, U22.6
SDA: J7.1, R9.1, R74.1, U12.4, U22.4
V12_PREFUSE: F1.1, T1.4
VCC: C28.1, C33.1, C64.1, C66.1, C75.1, C76.1, F1.2, R101.2, U2.3, U2.5, U19.8
r0: Q5.3, R58.2
r1: Q6.3, R59.2
r2: Q7.3, R60.2
r3: Q8.3, R61.2
r4: Q9.3, R62.2
r5: Q10.3, R63.2
r6: Q11.3, R64.2
r7: Q12.3, R65.2
r8: Q13.3, R82.2
r9: Q14.3, R83.2
r10: Q15.3, R84.2
r11: Q16.3, R85.2
r12: Q17.3, R86.2
r13: Q18.3, R87.2
r14: Q19.3, R88.2
r15: Q20.3, R89.2
r16: Q21.3, R106.2
r17: Q22.3, R107.2
r18: Q23.3, R108.2
r19: Q24.3, R109.2
r20: Q25.3, R110.2
r21: Q26.3, R111.2
r22: Q27.3, R112.2
r23: Q28.3, R113.2
