w-dee/dotmatrix_64x48_hw_5.0/(commit log)

2017-09-12 Modified to use matrix LEDs; Components layout has almost done, tracks and traces not yet.
    [IR_Sensor.sch, column_driver.sch, dotmatrix_64x48.sch, fet-driver.sch, ledmatrix.sch, power.sch, row_driver.sch, signal_driver.sch]
2017-09-16 Layout almost complete.
    [dotmatrix_64x48.kicad_pcb]
2017-09-16 Silk fix; Pattern pull out from ICs fiexed; Vias on pads fixed
    [dotmatrix_64x48.kicad_pcb]
2017-09-17 Set away thermelly active components from sensors; Silks and DRC not yet done
    [dotmatrix_64x48.kicad_pcb]
2017-09-17 Improved GND impedance
    [dotmatrix_64x48.kicad_pcb]
2017-09-17 Added serial pull-ups; DRC clear; Silks should be clear.
    [IR_Sensor.sch, column_driver.sch, dotmatrix_64x48.kicad_pcb, dotmatrix_64x48.sch, fet-driver.sch, power.sch, row_driver.sch, signal_driver.sch]
2017-09-18 Layout adj. DRC clear
    [dotmatrix_64x48.kicad_pcb]
2017-09-19 Layout improvements; DRC clear
    [dotmatrix_64x48.kicad_pcb]
2017-09-24 Fixed LED matrix module's orientation; DRC clear
    [dotmatrix_64x48.kicad_pcb]
2017-09-24 Impedance improvements; DRC clear
    [dotmatrix_64x48.kicad_pcb]
2017-09-25 Removed termination resisters (was never used in 3.0 series); Pattern improvements; DRC clear
    [IR_Sensor.sch, column_driver.sch, dotmatrix_64x48.kicad_pcb, dotmatrix_64x48.sch, fet-driver.sch, ledmatrix.sch, power.sch, row_driver.sch]
2017-09-26 Small fixes; DRC clear
    [dotmatrix_64x48.kicad_pcb]
2017-10-02 DRC clear; This project likely to be abandoned due to 4MiB Flash version WROOM-02 shortage.
    [dotmatrix_64x48.kicad_pcb]
2017-10-13 This is the MazoClock hw 4.0 series; Uses ESP32 processor instead of ESP8266 used in prior MazoClock hw 3.0 series.
    [IR_Sensor.sch, column_driver.sch, dotmatrix_64x48.kicad_pcb, dotmatrix_64x48.sch, fet-driver.sch, ledmatrix.sch, power.sch, row_driver.sch]
2017-10-14 Fixed button position; DRC clear
    [dotmatrix_64x48.kicad_pcb]
2017-10-16 Added some DC-DC convertes; DRC clear
    [dotmatrix_64x48.kicad_pcb, power.sch]
2017-10-22 Added quick-and-dirty class-D amplifier circuit for just testing
    [IR_Sensor.sch, column_driver.sch, dotmatrix_64x48.kicad_pcb, dotmatrix_64x48.sch, fet-driver.sch, ledmatrix.sch, power.sch, row_driver.sch]
2018-09-25 Updated to kicad 6.0.0 rc; removed outdated gerber files; Schematic is not complete
    [IR_Sensor.sch, column_driver.sch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]
2018-10-17 Heavily modifying; Matrix nets under construction
    [IR_Sensor.sch, column_driver.sch, dotmatrix_64x48.kicad_pcb, dotmatrix_64x48.sch, fet-driver.sch, ledmatrix.sch, power.sch, row_driver.sch]
2018-10-18 Getting very mojai
    [dotmatrix_64x48.kicad_pcb]
2018-10-27 Almost all components has placed.
    [IR_Sensor.sch, column_driver.sch, dotmatrix_64x48.kicad_pcb, dotmatrix_64x48.sch, fet-driver.sch, ledmatrix.sch, power.sch, row_driver.sch]
2018-11-05 Too less PCB space.
    [IR_Sensor.sch, dotmatrix_64x48.kicad_pcb, dotmatrix_64x48.sch, power.sch, usb_uart.sch]
2018-11-09 Added stereo power amplifier
    [IR_Sensor.sch, column_driver.sch, dotmatrix_64x48.kicad_pcb, dotmatrix_64x48.sch, fet-driver.sch, ledmatrix.sch, power.sch, power_amp.sch]
2018-11-14 Switched to new kicad libraries
    [IR_Sensor.sch, column_driver.sch, dotmatrix_64x48.kicad_pcb, dotmatrix_64x48.sch, fet-driver.sch, power.sch, power_amp.sch, row_driver.sch]
2018-11-20 Layout fixup
    [IR_Sensor.sch, dotmatrix_64x48.kicad_pcb]
2018-11-24 Refdeses fixup; There is bunch of Courtyard crossing; I'm going to ignore them. Anyway this board is only for handsoldering.
    [dotmatrix_64x48.kicad_pcb]
2018-12-01 Layout fixes
    [dotmatrix_64x48.kicad_pcb]
2019-10-07 Version 4.0 commit
    [IR_Sensor.sch, column_driver.sch, dotmatrix_64x48.kicad_pcb, dotmatrix_64x48.sch, fet-driver.sch, ledmatrix.sch, power.sch, power_amp.sch]
2019-10-08 Prior to merge production-1.0's led matrix pattern
    [IR_Sensor.sch, column_driver.sch, dotmatrix_64x48.kicad_pcb, dotmatrix_64x48.sch, fet-driver.sch, ledmatrix.sch, power.sch, power_amp.sch]
2019-10-08 Merged production-1.0's LED matrix onto current design.
    [IR_Sensor.sch, dotmatrix_64x48.sch, fet-driver.sch, ledmatrix.sch, power.sch]
2019-10-16 Before removing old style stitching vias
    [IR_Sensor.sch, dotmatrix_64x48.sch, power.sch, usb_uart.sch]
2019-10-23 Design update
    [usb_uart.sch]
2019-10-31 Almost done drawing pcb tracks
    [IR_Sensor.sch, dotmatrix_64x48.sch, power.sch, usb_uart.sch]
2019-11-01 DRC complete. MK5
    [power.sch]
2019-11-02 Prototype gerber out done
2019-11-03 Prototype gerber out done, retaken
2019-11-10 Added power input filter circut; Adjust MLCC size/value to be able to use cheap components
    [IR_Sensor.sch, power.sch, usb_uart.sch]
2019-11-11 Changed footprints from old 4.x's R/C to 5.x's
    [IR_Sensor.sch, column_driver.sch, dotmatrix_64x48.sch, fet-driver.sch, power.sch, row_driver.sch, usb_uart.sch]
2019-11-11 Re-arranged schematic texts not to overlap each other
    [IR_Sensor.sch, column_driver.sch, dotmatrix_64x48.sch, power.sch, row_driver.sch, usb_uart.sch]
2019-11-11 Moved SD-related resistors to near ESP32
2019-11-12 Removed led address text and aruco markers; Added scale label instead
2019-11-12 Added via on pads of SMD connector not to easily be detatched from base FR-4
2019-11-18 Track refining
2019-11-21 Added external IR remote-controller connector; DRC clear
    [IR_Sensor.sch, dotmatrix_64x48.sch]
2019-11-25 Relocated buttons to more easily accessible position
    [dotmatrix_64x48.sch]
2019-11-25 Specified 3V3 LDO as ON semi NCP1117 because its document shows stable MLCC output capacitor capcity/ESR range
    [power.sch]
2019-11-26 Changed HC595's vdd from LEDVDD to LEDLOGICVDD; Fixed silk refdes'; DRC clean ?(unchecked)
    [fet-driver.sch, power.sch, row_driver.sch]
2019-11-27 Fixed USB micro-b's mount polarity; Improved SOT-23-6 1-pin silk marker readability
    [IR_Sensor.sch, dotmatrix_64x48.sch, power.sch, row_driver.sch, usb_uart.sch]
2019-12-02 LEDVDD now can be up to 5.0V for blue/white LEDs; DRC clear
    [dotmatrix_64x48.sch, power.sch, row_driver.sch]
2019-12-02 Wrote note about making LEDVDD > 4.5V
    [power.sch, row_driver.sch]
2019-12-04 Changed I2S ESD diode's returning VDD from LED1642VDD to LEDLOGICVDD
    [IR_Sensor.sch]
2019-12-04 Fixed IR LED drive voltage range
    [IR_Sensor.sch]
2020-01-02 Fixed WROOM-32D footprinco; NO DRC CHECKED
    [IR_Sensor.sch, dotmatrix_64x48.sch]
2020-01-03 Improved LDO heat dissipation; Button and its diodes rearranged
2020-01-06 Added 4-pin USB pin header connector in case of getting crazy of USB micro-B comming off
    [usb_uart.sch]
2020-01-06 Improved power impedance
2020-01-07 Improved USB micro-b connector strength
2020-01-15 Improved thermal dissipation around DC-DC converters
    [IR_Sensor.sch, column_driver.sch, dotmatrix_64x48.sch, fet-driver.sch, ledmatrix.sch, power.sch, row_driver.sch, usb_uart.sch]
2020-06-30 Schematics format change due to KiCAD's verup
    [IR_Sensor.kicad_sch, IR_Sensor.sch, column_driver.kicad_sch, column_driver.sch, dotmatrix_64x48.kicad_sch, dotmatrix_64x48.sch, fet-driver.kicad_sch, fet-driver.sch]
2020-06-30 Removed old format files
    [IR_Sensor.sch, column_driver.sch, dotmatrix_64x48.sch, fet-driver.sch, ledmatrix.sch, power.sch, row_driver.sch, usb_uart.sch]
2020-07-06 Button component change and removed some ESD diodes
    [IR_Sensor.kicad_sch, column_driver.kicad_sch, dotmatrix_64x48.kicad_sch, fet-driver.kicad_sch, ledmatrix.kicad_sch, power.kicad_sch, row_driver.kicad_sch, usb_uart.kicad_sch]
2020-07-07 GND impedance improvement
2020-07-11 Added a schematic PDF
2020-07-11 Added C80 / removed orphan GND in the schematics
    [IR_Sensor.kicad_sch, column_driver.kicad_sch, dotmatrix_64x48.kicad_sch, fet-driver.kicad_sch, ledmatrix.kicad_sch, power.kicad_sch, row_driver.kicad_sch, usb_uart.kicad_sch]
2020-07-11 Swapped Q31 E/C / DRC clear
    [IR_Sensor.kicad_sch, dotmatrix_64x48.kicad_sch, power.kicad_sch, usb_uart.kicad_sch]
2020-07-13 Renamed Master/Slave to 責め/受け due to trend of avoidance of discriminative words
    [IR_Sensor.kicad_sch, dotmatrix_64x48.kicad_sch, usb_uart.kicad_sch]
2020-07-13 Updated schematic PDF
2020-08-17 Added C before LDO / DRC clear
    [IR_Sensor.kicad_sch, column_driver.kicad_sch, dotmatrix_64x48.kicad_sch, fet-driver.kicad_sch, ledmatrix.kicad_sch, power.kicad_sch, row_driver.kicad_sch, usb_uart.kicad_sch]
2020-08-17 Updated the schematic
2020-08-21 WROOM32 coupling capacitor order fixed; Added FB on long line to board left-most sensors
    [IR_Sensor.kicad_sch, column_driver.kicad_sch, dotmatrix_64x48.kicad_sch, fet-driver.kicad_sch, ledmatrix.kicad_sch, power.kicad_sch, row_driver.kicad_sch, usb_uart.kicad_sch]
2020-08-24 Changed from USB micro-B to Type C. DRC should be clear.
    [IR_Sensor.kicad_sch, column_driver.kicad_sch, dotmatrix_64x48.kicad_sch, fet-driver.kicad_sch, ledmatrix.kicad_sch, power.kicad_sch, row_driver.kicad_sch, usb_uart.kicad_sch]
2020-08-26 Switched to kicad-nightly (not legacy) official repository
    [IR_Sensor.kicad_sch, column_driver.kicad_sch, dotmatrix_64x48.kicad_sch, fet-driver.kicad_sch, ledmatrix.kicad_sch, power.kicad_sch, row_driver.kicad_sch, usb_uart.kicad_sch]
2020-08-27 Fixed bypass capacitor positions; DRC clear
    [IR_Sensor.kicad_sch, column_driver.kicad_sch, dotmatrix_64x48.kicad_sch, fet-driver.kicad_sch, ledmatrix.kicad_sch, power.kicad_sch, row_driver.kicad_sch, usb_uart.kicad_sch]
2020-08-28 Added an external pull-up resistor on GPIO0
    [dotmatrix_64x48.kicad_sch, usb_uart.kicad_sch]
2020-08-31 Added IR led protection
    [IR_Sensor.kicad_sch, dotmatrix_64x48.kicad_sch, usb_uart.kicad_sch]
2020-09-01 LEDVDD improvments
2020-09-02 Added IR transmit status 'visible' indicator
    [IR_Sensor.kicad_sch, dotmatrix_64x48.kicad_sch, usb_uart.kicad_sch]
2020-09-02 Small improvements
    [IR_Sensor.kicad_sch, dotmatrix_64x48.kicad_sch]
2020-09-07 Added some comments
    [IR_Sensor.kicad_sch, column_driver.kicad_sch, dotmatrix_64x48.kicad_sch, fet-driver.kicad_sch, ledmatrix.kicad_sch, power.kicad_sch, row_driver.kicad_sch, usb_uart.kicad_sch]
2020-09-07 Updated schematics PDF
2020-09-08 Fixed some comments; Added FB on SCL/SDA line
    [IR_Sensor.kicad_sch, dotmatrix_64x48.kicad_sch, power.kicad_sch, usb_uart.kicad_sch]
2020-09-09 Updated the PCB; DRC clear
    [IR_Sensor.kicad_sch, dotmatrix_64x48.kicad_sch]
2020-09-17 Re-arranged physical buttions; DRC clear
    [IR_Sensor.kicad_sch, column_driver.kicad_sch, dotmatrix_64x48.kicad_sch, fet-driver.kicad_sch, ledmatrix.kicad_sch, power.kicad_sch, row_driver.kicad_sch, usb_uart.kicad_sch]
2020-09-20 Use BAT54A instead of discrete Ds; DRC NOT clear
    [IR_Sensor.kicad_sch, column_driver.kicad_sch, dotmatrix_64x48.kicad_sch, fet-driver.kicad_sch, ledmatrix.kicad_sch, power.kicad_sch, row_driver.kicad_sch, usb_uart.kicad_sch]
2020-09-21 Completed Board Fix; DRC should be OK ...
2020-09-21 Changed 5.05V buck regulator output to 4.65V (to decrease 3.3V LDO heat)
    [dotmatrix_64x48.kicad_sch, power.kicad_sch, usb_uart.kicad_sch]
2020-09-21 Schematics update
2020-09-23 Added J8.4; DRC clear
    [IR_Sensor.kicad_sch, dotmatrix_64x48.kicad_sch, power.kicad_sch, usb_uart.kicad_sch]
2020-09-23 Added some ferrite beads on sensitive lines
    [dotmatrix_64x48.kicad_sch, usb_uart.kicad_sch]
2020-09-24 Removed SCL/SDA FBs
    [dotmatrix_64x48.kicad_sch, usb_uart.kicad_sch]
2020-09-24 Moved leftside sensors to rightside; Unified old footprints to new footprints; DRC clear
    [IR_Sensor.kicad_sch, dotmatrix_64x48.kicad_sch, fet-driver.kicad_sch, power.kicad_sch, usb_uart.kicad_sch]
2020-09-26 Changed LDO to one which has more lower drop voltage; DRC clear
    [IR_Sensor.kicad_sch, dotmatrix_64x48.kicad_sch, power.kicad_sch, usb_uart.kicad_sch]
2020-09-26 Fixed a comment mismatch; Why KiCAD changes more files than I edited ...
    [dotmatrix_64x48.kicad_sch, power.kicad_sch, usb_uart.kicad_sch]
2020-10-09 To use WS2812-2020 as status LEDs; No critical DRC errors found
    [IR_Sensor.kicad_sch, column_driver.kicad_sch, dotmatrix_64x48.kicad_sch, power.kicad_sch, usb_uart.kicad_sch]
2020-10-12 Traces fix; DRC may clear
2020-11-17 Routing adjustments; DRC should be ok
    [IR_Sensor.kicad_sch, column_driver.kicad_sch, dotmatrix_64x48.kicad_sch, fet-driver.kicad_sch, ledmatrix.kicad_sch, power.kicad_sch, row_driver.kicad_sch, usb_uart.kicad_sch]
2020-11-18 Changed environment light sensor position; DRC clear
    [IR_Sensor.kicad_sch, dotmatrix_64x48.kicad_sch, usb_uart.kicad_sch]
2020-11-30 Gerber out
2021-01-13 Added a schematic comments; I don't know why other files are updated
    [IR_Sensor.kicad_sch, column_driver.kicad_sch, dotmatrix_64x48.kicad_sch, fet-driver.kicad_sch, ledmatrix.kicad_sch, power.kicad_sch, row_driver.kicad_sch, usb_uart.kicad_sch]
2021-01-28 Changed L2 value from 2.2uH to '2.2 ~ 6.8uH'
    [IR_Sensor.kicad_sch, column_driver.kicad_sch, dotmatrix_64x48.kicad_sch, fet-driver.kicad_sch, ledmatrix.kicad_sch, power.kicad_sch, row_driver.kicad_sch, usb_uart.kicad_sch]
2021-02-01 Settled L2 value to 6.8uH
    [IR_Sensor.kicad_sch, column_driver.kicad_sch, dotmatrix_64x48.kicad_sch, fet-driver.kicad_sch, ledmatrix.kicad_sch, power.kicad_sch, row_driver.kicad_sch, usb_uart.kicad_sch]
2021-02-12 Modified BAT54A -> BAT54AT
    [dotmatrix_64x48.kicad_sch, row_driver.kicad_sch]
2021-02-16 Revert "Modified BAT54A -> BAT54AT"
    This reverts commit bff826c2a0df659e4b46f46fdcd99af7f60e1fdb.
    [dotmatrix_64x48.kicad_sch, row_driver.kicad_sch]
2021-03-10 Relocated LED's AK notation
2021-03-22 Improved GND impedance a bit; courtyard overlap fix
2021-03-23 Fixed twisted resistor positioning
2021-03-26 Reverted L2 value from '6.8u' to '2.2u'. Instead, L7 has changed its value from '2.2u' to '6.8u' to preserve total component BOM. The reason is sound noise from L2.
    [IR_Sensor.kicad_sch, dotmatrix_64x48.kicad_sch, fet-driver.kicad_sch, ledmatrix.kicad_sch, power.kicad_sch, usb_uart.kicad_sch]
2021-04-05 Experimental modification for audible noise redution at DC-DC converters
    [dotmatrix_64x48.kicad_sch, power.kicad_sch]
2021-04-07 Enbold GND patterns
2021-04-13 Improved SD card VDD line
    [dotmatrix_64x48.kicad_sch]
2021-04-14 Improved audible noize reduction; DRC clear
    [dotmatrix_64x48.kicad_sch, power.kicad_sch, row_driver.kicad_sch]
2021-04-16 Removed PML caps; I concluded they do not help audible noise reduction; DRC clear
    [dotmatrix_64x48.kicad_sch, power.kicad_sch]
2021-05-04 Reverted L2 value to 6.8uH (Sorry I have bought too many 6.8uH'sgit statusgit status)
    [dotmatrix_64x48.kicad_sch, power.kicad_sch]
2021-07-09 KiCAD ver. up
2021-07-09 Added C94; Moved I2C pull-up Rs to more near MCU
    [dotmatrix_64x48.kicad_sch, fet-driver.kicad_sch]
